syahrilTGR/IoT_BuahNagaFarm/images/esp32 38pin.webp

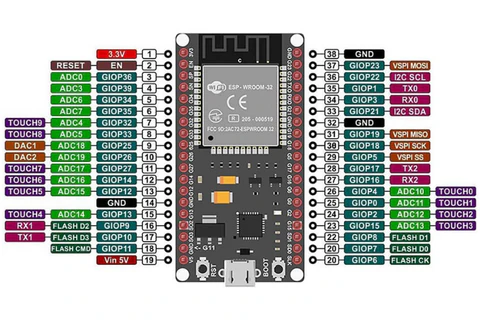
images/esp32 38pin.webp
