syahrilTGR/IoT_BuahNagaFarm/MEMORY.md

# Project Memory Index

- [Project Progress](memory/project-progress.md) — Current status: WiFi + Firebase + LED working, GPIO0 button not functional
