syahrilTGR/IoT_BuahNagaFarm/docs/note.md

Ukuran P x L (CM) :

plat panel :
43.7 x 37.2 

PSU :
11 x 7.8 
diameter lubang 3.5, jarak lubang (atas kiri) ke sisi samping 3 mm, dari atas ke sisi dalam 3.5 mm
lubang (bawah kanan): jarak dari samping 3.5 mm, dari bawah 2.5 mm
-miring:
Lubang bawah: dari bawah 3 mm, dari samping 7.1 mm
Lubang atas: dari atas 5.5 (sisi dalam), dari samping 7 mm

PCB:
15 x 10

PZEM :
7.5 x 3 , jarak tepi lubang 1 mm, diameter 3 mm

SSR :
3.5 x 2.5
jarak lubang ke tepi 1.5, diameter 3

SSR 2 chl:
55 x 33.1 mm,
jarak tepi ke lubang 1.5mm,
diameter lubang 3mm

zmpt
5.13 x 2.1
lubang ke tepi 1.5, diameter 2.5

lubang konektor fan: 7.2 x 6

PR:
switch kanan di align top dgn oled
screw terminal buat zmpt

relay 2 ch:
38.5 x 50
lubang ke atas 0.75 mm
lubang ke samping 0.75 mm
jarak sisi dalam lubang horizontal 30 mm
vert 42.5 mm
position:
163.83
7.366

jarak lubang ke sisi sisi : 0.8 rata - worstcase

----
note hardware:
- buzzer yang beep beep selama mati lampu, ganti dengan beep panjang 2 detik di awal mati lampu aja
