syahrilTGR/IoT_BuahNagaFarm/docs/2026-08-19-rtos-plan.md

# RTOS Implementation Plan — SmartNaga ESP32

**Tanggal:** 2026-08-19
**Status:** Planning
**Branch:** `feature/rtos-refactor`

---

## Goal

Refactor firmware ke FreeRTOS (3 task) agar buzzer & sensor tidak pernah blocking satu sama lain.

---

## Task Architecture

```
┌─────────────────────────────────────────────────────────────┐
│                      SMARTNAGA RTOS                         │
├──────────────────────┬──────────────────────┬────────────────┤
│   TASK BUZZER        │   TASK SENSOR        │  TASK NETWORK  │
│   (priority 3)       │   (priority 2)       │  (priority 1)  │
│   stack: 2048        │   stack: 4096        │  stack: 4096   │
├──────────────────────┼──────────────────────┼────────────────┤
│ - buzzer_on/off      │ - readPZEM()         │ - sendToFirebase()
│ - pln_alarm_repeat   │ - readZMPT()         │ - checkFirebaseCmds()
│ - toggle beep        │ - updateOLED()       │ - heartbeat
│ - silence_gap check  │ - queue data to NET  │ - queue data to SENSOR
├──────────────────────┼──────────────────────┼────────────────┤
│ PERIOD: 50ms         │ PERIOD: 100ms/1s/5s  │ PERIOD: 1s     │
│ QUEUE: buzzer_cmd    │ QUEUE: sensor_data   │ QUEUE: net_cmd │
└──────────────────────┴──────────────────────┴────────────────┘
```

---

## Queue Structure

```cpp
// Buzzer command queue (from Sensor/Network → Buzzer)
struct BuzzerCmd {
    enum Type { BEEP_200, BEEP_500 };
    Type type;
};
QueueHandle_t buzzerQueue;

// Sensor data queue (Sensor → Network)
struct SensorData {
    float blockA_V, blockA_I, blockA_P, blockA_E;
    float blockB_V, blockB_I, blockB_P, blockB_E;
    float zmpRms;
    bool plnAvailable;
    uint32_t timestamp;
};
QueueHandle_t sensorQueue;

// Network command queue (Network → Sensor/Buzzer)
struct NetCmd {
    enum Type { SET_LAMP_A, SET_LAMP_B, REQ_SYNC };
    Type type;
    bool state;
};
QueueHandle_t netCmdQueue;
```

---

## Implementation Steps

### Phase 1: FreeRTOS Setup (Day 1)
- [ ] Add `#include <freertos/FreeRTOS.h>` etc
- [ ] Create queues in `setup()`
- [ ] Create 3 tasks with proper priority/stack
- [ ] Test basic task scheduling (LED blink on each task)

### Phase 2: Buzzer Task (Day 1-2)
- [ ] Move buzzer logic ke `buzzerTask()`
- [ ] Receive from `buzzerQueue` (blocking receive)
- [ ] Implement internal timer (no external `millis()` dependency)
- [ ] Test: toggle A/B → beep 200ms, PLN off → beep 500ms/3s

### Phase 3: Sensor Task (Day 2-3)
- [ ] Move `readPZEM()`, `readZMPT()`, `updateOLED()` ke `sensorTask()`
- [ ] `readPZEM()` blocking OK di task ini (tidak ganggu buzzer)
- [ ] Push `SensorData` ke `sensorQueue` setiap 1s/5s
- [ ] Handle `netCmdQueue` untuk toggle lamp

### Phase 4: Network Task (Day 3)
- [ ] Move `sendToFirebase()`, `checkFirebaseCommands()` ke `networkTask()`
- [ ] Receive dari `sensorQueue` → push ke Firebase
- [ ] Poll `/lamp/control/{a,b}` → push ke `netCmdQueue`
- [ ] Heartbeat tiap 1s

### Phase 5: Integration & Testing (Day 4)
- [ ] End-to-end test: toggle A/B, PLN off/on, OLED, Firebase
- [ ] Verify no buzzer miss saat Firebase timeout 10s
- [ ] Stack watermark check (uxTaskGetStackHighWaterMark)
- [ ] Heap monitoring

---

## Priority & Timing

| Task | Priority | Period | Notes |
|---|---|---|---|
| Buzzer | 3 (high) | 50ms | Must never miss deadline |
| Sensor | 2 (med) | 100ms/1s | Blocking allowed |
| Network | 1 (low) | 1s | Can lag, non-critical |

**Priority inversion avoidance:** Gunakan `xQueueSend/Receive` dengan timeout, bukan mutex.

---

## Migration Checklist

| Legacy Code | RTOS Replacement |
|---|---|
| `loop()` | 3 tasks + queues |
| `Timer` struct + `millis()` | `vTaskDelayUntil()` / task period |
| `buzzerOn()` | `xQueueSend(buzzerQueue, ...)` |
| `readPZEM()` blocking | Sensor task internal |
| `sendToFirebase()` blocking | Network task internal |
| Global vars (`acVoltage`, `blockA`, etc) | Queue/notification passing |

---

## Memory Estimate

| Component | RAM |
|---|-----|
| 3 Task stacks | ~10KB |
| 3 Queues (small) | ~2KB |
| FreeRTOS kernel | ~4KB |
| **Total overhead** | **~16KB** (of 320KB) — acceptable |

---

## Rollback Plan

Jika RTOS gagal / crash:
- Branch terpisah `feature/rtos-refactor`
- Commit tiap phase untuk bisect
- Tag `pre-rtos` untuk rollback cepat

---

## Risks & Mitigation

| Risk | Mitigation |
|---|---|
| Stack overflow | `configCHECK_FOR_STACK_OVERFLOW=2`, `uxTaskGetStackHighWaterMark()` |
| Priority inversion | Queues + timeout, no mutex |
| Watchdog reset | Buzzer task feed watchdog; `CONFIG_ESP_TASK_WDT_TIMEOUT_S=30` |
| Queue full | `xQueueSend` timeout 0 (non-blocking), log drop |

---

## Success Criteria

- [ ] Buzzer beep 200ms/500ms **tidak pernah miss** walau Firebase timeout 30s
- [ ] PLN off → beep 500ms/3s **bersih tanpa overlap**
- [ ] OLED update 1s **tidak skip** walau PZEM 7s blocking
- [ ] Energy data ke Firebase **max 2s delay** dari sensor read
- [ ] Binary < 1.2MB flash, RAM < 200KB

---

## Next Action

Implement Phase 1-2 (Buzzer Task) — paling critical, paling cepat verify.
