syahrilTGR/IoT_BuahNagaFarm/memory/project-progress.md

---
name: project-progress
description: "Current progress of SmartNaga ESP32 firmware testing - WiFi, Firebase, LED working"
metadata: 
  node_type: memory
  type: project
  originSessionId: 16ef7975-35da-4052-ae32-14b6238d7351
  modified: 2026-07-28T07:57:29.177Z
---

## Progress Test Platform (test_platform.cpp)

### ✅ Working (2026-07-28)
- WiFi Manager: ESP32 bisa connect WiFi via AP portal
- Firebase RTDB: Upload status berhasil ke `/test/status`
- LED builtin (GPIO2): Belum diuji via Firebase command
- **GPIO4 sebagai test button input (dengan pullup internal)**

### ⚠️ Issues (Resolved)
- ~~GPIO0 (Boot button) tidak bisa dipakai untuk input — pin khusus download mode~~ → **Fixed: gunakan GPIO4**
- ESP32 pakai **38 pin** DevKit (bukan 30 pin)

### Hardware
- ESP32 DevKit 38-pin
- Pin: D13 → LLC → SSR (Blok A), D12 (Blok B), PZEM di RX2/TX2 (GPIO16/17)
- Builtin LED: GPIO2 (active LOW)

### Credentials
- Firebase project: control-and-monitoring-energy
- Firebase URL: https://control-and-monitoring-energy-default-rtdb.asia-southeast1.firebasedatabase.app/

### Environment
- `pio run -e test_platform` — build test firmware
- `pio run -t upload -e test_platform` — upload test firmware
- `pio monitor -e test_platform` — monitor serial

**Why:** Proyek sedang dalam tahap testing komponen dasar sebelum integrasi penuh.
**How to apply:** Lanjutkan testing dengan pin GPIO lain (bukan GPIO0/Boot button) untuk input/output test.
