syahrilTGR/IoT_BuahNagaFarm/hardware/Manual Book/LEMBAR_PANDUAN_RINGKAS_PANEL.md

# LEMBAR PANDUAN CEPAT (SOP PINTU PANEL)
## ALAT KONTROL LAMPU KEBUN BUAH NAGA — SMARTNAGA

> *Petunjuk ringkas untuk ditempel pada bagian dalam pintu box panel kebun.*

---

### 1. CARA MENYALAKAN ALAT (PAGI / PERTAMA KALI)
1. Colokkan kabel kontrol ke baterai cadangan (UPS).
2. Naikkan tuas **MCB Utama** ke atas (posisi **ON**).
3. Naikkan tuas **MCB Lampu** ke atas (posisi **ON**).
4. Tunggu bunyi *"Tit"* 1 kali dan layar kecil menampilkan jam kebun.

---

### 2. CARA SAMBUNG KE WIFI / MODEM BARU (3 MENIT)
Jika di layar muncul tulisan **`== SETUP WIFI ==`**:
1. Buka WiFi di HP ➔ Sambungkan ke **`SmartNaga-AP`** (Sandi: **`smartnaga123`**).
2. Buka Google Chrome di HP ➔ Buka alamat: **`192.168.4.1`**.
3. Klik **Configure WiFi** ➔ Pilih WiFi kebun Anda ➔ Masukkan sandinya.
4. Klik **Save**. Tunggu alat me-restart sendiri hingga layar tertulis **`Wifi: online`**.

---

### 3. ARTI TAMPILAN LAYAR KECIL
```
┌──────────────────────────────┐
│           19:15:00           │ ➔ Jam Kebun (Otomatis & Tepat)
│ Wifi: online 42ms            │ ➔ Internet Terhubung Lancar
│ Source: PLN                  │ ➔ Listrik Utama PLN Aktif
│ Blok A: 850W                 │ ➔ Pemakaian Listrik Blok A
│ Status: 10/10 Normal         │ ➔ Semua Lampu Blok A Sehat
│ Blok B: 850W                 │ ➔ Pemakaian Listrik Blok B
│ Status: 10/10 Normal         │ ➔ Semua Lampu Blok B Sehat
└──────────────────────────────┘
```

---

### 4. ARTI BUNYI ALARM
* **Bunyi "Tit" Pendek (1x):** Tanda saklar di HP berhasil ditekan (ON / OFF).
* **Bunyi "Tiiiiiit" Panjang (2 Detik):** **LISTRIK PLN PADAM!** Sistem beralih ke baterai cadangan dan mengirim peringatan ke HP pemilik kebun.

---

### 5. TINDAKAN CEPAT SAAT TERJADI KENDALA

| Tulisan di Layar | Apa Artinya? | Tindakan yang Harus Dilakukan |
|---|---|---|
| **`Status: 8/10 Normal`** | Ada 2 bohlam yang mati di kebun. | Sisir barisan pohon buah naga, cari 2 bohlam yang padam, lalu ganti dengan bohlam baru. |
| **`Status: Lampu Padam`** | Semua lampu mati padahal saklar ON. | Periksa tuas MCB Lampu di panel. Jika turun (trip), naikkan kembali. Jika langsung turun lagi, ada korsleting di kabel tiang. |
| **`Status: Listrik Padam`** | Aliran listrik PLN dari tiang jalan mati. | Tidak perlu diapa-apakan. Saat PLN kembali menyala, lampu akan otomatis hidup kembali. |
| **`Wifi: No Internet`** | Kuota modem habis / sinyal hilang. | Periksa paket kuota modem 4G kebun. Lampu tetap menyala sesuai jadwal otomatis. |
| **`Status: Relay Bocor`** | Lampu tetap nyala padahal saklar OFF. | Turunkan tuas MCB Lampu sementara waktu agar hemat listrik, lalu hubungi teknisi. |

---

### ⚠️ PERINGATAN KESELAMATAN (K3)
1. **Dilarang menyentuh kabel telanjang** saat listrik sedang menyala.
2. Selalu gunakan **alas kaki karet kering** saat membuka panel.
3. Selalu **kunci pintu box panel rapat-rapat** setelah selesai agar tidak kemasukan air hujan dan serangga.
