syahrilTGR/IoT_BuahNagaFarm/todo.md

pelajari:
- millis()
- rangkaian pzem ke esp32

note:
- yg ke SSR itu yg line phase
- esp32 ada berapa uart
- nyalanya lampu tu ngga semalaman
- ssr udah bisa, dari esp langsung ssr, sebelumnya pake LLC, gabisa, kyk nya LLC nya rusak, di sisi 5v ngga mau ke state low

di esp
- daya di oled buat atas bawah aja

di App
- [x] tambah estimasi rup
- [x] coba ekspor historis dari firestore ke spreadsheet/csv
- [x] di setting, tambahkan inputan daya dan jumlah lampu default, yang nantinya disimpan ke firebase dan digunakan sebagai acuan kondisi normal atau tidak
- [x] notif lampu padam (dari ZMPT), nanti source nya berubah jadi UPS

di App — PERLU DIPERBAIKI (temuan audit firmware 2026-09-25)
- [x] **`_zmptVoltage` sebenarnya berisi tegangan PZEM Blok A, bukan ZMPT.**
      Di `home_screen.dart` ada DUA listener menulis ke `_zmptVoltage`:
        1. `_plnRef.child('voltage')` (L162) → `/energy/pln_status/voltage` **TIDAK ADA** → listener mati, tidak pernah fire
        2. `_energyRefA.child('voltage')` (L172) → `/energy/block_a/voltage` → ini yang jalan (PZEM, ~238V)
      Jadi tampilan tegangan "kebetulan" benar angkanya, tapi sumbernya PZEM Blok A — bukan ZMPT.
      → Hapus listener mati (L162-170), dan putuskan mau pakai yang mana:
        - **PZEM Blok A** (tegangan di sisi beban) — kalau mau tetap seperti sekarang, rename variabelnya
        - **ZMPT** (`/energy/z_mpt/voltage_real`, tegangan di jalur PLN sebelum stopkontak) — kalau mau bedakan
- [x] **Field baru `voltage_real`** — firmware kirim volt terkalibrasi (RMS × 0.667) ke
      `/energy/z_mpt/voltage_real`. Ini satu-satunya sumber tegangan dari ZMPT.
- [x] **`voltage_raw` = RMS ADC mentah, BUKAN volt** — nilainya ~0-500 (contoh 356), bukan ~238.
      Jangan ditampilkan sebagai volt.
- [x] **Heartbeat staleness tidak konsisten** — `control_screen.dart` pakai 10s, `home_screen.dart`
      pakai 15s. Firmware kirim tiap 2.5s. Samakan (usul 10s = 4 beat terlewat).
- [x] **Status PLN bisa flicker saat transisi** — firmware kirim `/energy/pln_status/available`
      dari nilai INSTAN, bukan yang sudah di-debounce. Saat PLN baru mati/nyala, app bisa
      sempat menampilkan status salah ~300ms. Pertimbangkan smoothing di app (debounce 2-3s)
      atau perbaiki di firmware (pakai `plnPrevState`).
- [x] **BUG: arus & daya stuck di nilai terakhir saat PLN mati** (dilaporkan 2026-09-25)
      Gejala: PLN normal + lampu nyala → terukur arus & daya. Lalu PLN mati →
      nilai arus/daya **tidak reset ke 0**, tetap menampilkan angka terakhir.

      **Akar masalah ADA DI FIRMWARE, bukan app.** Alur:
        1. `src/main.cpp:341` — `readPZEM()` di-SKIP total saat PLN mati:
           `if (now - timerPZEM.prev >= timerPZEM.interval && plnPrevState)`
        2. `blockA` / `blockB` jadi variabel basi (nilai terakhir sebelum PLN mati)
        3. `sendToFirebase()` tetap kirim `blockA.power` / `blockA.current` yang basi
           itu ke `/energy/block_{a,b}` setiap 2.5s
        4. App menerima nilai valid → tidak ada cara tahu itu sudah tidak berlaku

      **Fix firmware — yang harus dilakukan:**
        Kirim `valid` di JSON `/energy/block_{a,b}`:

        ```cpp
        // Gabung dua kondisi — JANGAN kirim blockA.valid apa adanya!
        // Saat PLN mati, readPZEM() di-skip sehingga blockA.valid tetap
        // bernilai true dari pembacaan terakhir (basi).
        bool validA = plnPrevState && blockA.valid;
        bool validB = plnPrevState && blockB.valid;
        ```

        ⚠️ Jebakan: `blockA.valid` dihitung DI DALAM `readPZEM()` (L431).
        Karena `readPZEM()` di-skip saat PLN mati, nilai itu tidak pernah
        diperbarui → tetap `true`. Kalau dikirim apa adanya, bug tidak
        terselesaikan.

      **Catatan penting (dikoreksi 2026-09-25):** Lampu terhubung **langsung ke PLN
      tanpa UPS** — UPS hanya menopang ESP32 + sensor + modem 4G. Jadi saat PLN mati,
      lampu memang mati dan arus yang benar adalah **0**. Reset ke 0 adalah perilaku
      yang TEPAT, bukan sekadar workaround.

      Jadi Opsi A sudah benar. VCC PZEM 5V (item hardware) tetap layak dikerjakan
      untuk stabilitas komunikasi saat PLN normal, tapi tidak mengubah keputusan
      `valid` di atas.

      **Sisi app (SUDAH DIKERJAKAN):**
        - `home_screen.dart:132` pakai assignment langsung → ikut nilai dari Firebase,
          jadi otomatis benar begitu firmware kirim 0.
        - `anomaly_listener_service.dart` sudah baca flag `valid`:
          `final bool isValid = val['valid'] != false; if (!isValid) { _powerA = 0.0; ... }`

      ✅ **SELESAI — firmware sudah kirim flag `valid`** (commit 42328cd)
        ```cpp
        bool validA = plnPrevState && blockA.valid;
        bool validB = plnPrevState && blockB.valid;
        energyJson.set("valid", validA);
        ```
        Build sukses (RAM 16.0%, Flash 96.8%). Perlu diuji lapangan:
        PLN mati → arus/daya harus reset ke 0 di app.

di RTDB
- add tugangan zmpt ke firebase
- [/device/ping] tambah node ping: online (bool), latency_ms (int), timestamp (int), **ssid (string)** — [x] firmware sudah kirim

di hardware
- buzzer PLN mati: ganti beep-beep (500ms/3s) jadi beep panjang 2 detik di awal mati lampu aja [x]
- PZEM VCC: 3.3V → 5V (spec PZEM-004T v3.0 = 5V, komunikasi gagal saat PLN mati)
- PZEM AC input: pastikan dari UPS (bukan PLN) kalau mau tetap monitor saat outage
- ZMPT potentiometer: kalibrasi ulang (putar sampai baseline ~2200 dan RMS 230+) [x] — hasil: PLN ON RMS 355.5 Vpp 937, PLN OFF RMS 6.5 (margin 53x)
- voltage_raw di Firebase: nilai RMS ADC mentah, belum dikonversi ke volt
- tulisan src di oled, geser ke kanan, jdi tulisan ups atau PLN itu mentok ke kanan [x]
- trus tulisan wifi: ON / OFF, ganti dengan tulisan ONLINE, OFFLINE. cek apakah cukup ruang di olednya? [x]
- ESP32 reboot (POWERON_RESET) saat PLN dicabut — cek apakah disupply dari UPS atau USB saat test

di OLED (permintaan Pak Amin Rodhi, 2026-09-28)
- [x] Ping 8.8.8.8 tiap 3 detik → tampil "Wifi: online XXms" / "Wifi: offline"
- [x] Layout 7 baris: Waktu / Wifi+ping / Source / Blok A: daya / Status / Blok B: daya / Status
- [x] "Status" di Blok A/B = nilai daya (W) + status perintah SSR (ON/OFF)
- [x] Status label: `Rusak (N)` dengan `brokenLamps` (clamp 1..lampCount)
- [x] Font: size 1 untuk semua baris, waktu size 2 (paling besar di baris 1)
- [DICOBA, DIBATALKAN] Font FreeSans9pt7b (14px) sempat dicoba, tapi hasilnya
      kurang bagus — user revert ke size 1/2 built-in. Alasan teknis: font
      proportional hanya muat 4 baris, dan setCursor jadi baseline (bukan top-left)
      sehingga tata letak harus dirombak.

---

## Firmware
- [x] PZEM B baca data
- [x] SSR B pin dipindah ke GPIO27 (sekarang relay biasa 2-channel active LOW)
- [x] Timestamp pakai NTP epoch seconds
- [x] Firmware hanya tulis `/energy/block_{a,b}`, app handle `/lamp/status/{a,b}`
- [x] Debounce Firebase command (2s) cegah flicker saat SSL reconnect
- [x] Boot: semua lamp OFF, baca status dari RTDB setelah connect
- [x] Lamp B bisa dikontrol dari app (sudah di code, perlu test)
- [x] Decision tree 10-status di firmware (port presisi dari app)
- [x] Threshold identik app: leak 2.0W/0.05A, PLN 50V, under 190V, over 245V, broken 2.0W/0.3x, ppl 9.0W, tol 15%
- [x] Freshness gate: lastGoodMs + usable gate (10s)
- [x] sensorOk synthesis: inGrace || !plnPrevState || (valid && fresh)
- [x] Config dari Firebase: expected_power, lamp_count, tolerance_percent
- [x] Config polling: 5 menit → 10 detik (timerConfig)
- [x] Settling 4 detik post-toggle
- [x] OLED 7-label: `Rusak (N)` dengan brokenLamps clamp 1..lampCount
- [x] Relay boot glitch fix: digitalWrite(HIGH) SEBELUM pinMode(OUTPUT)
- [x] SSID ke Firebase: /device/ping.ssid

---

## App (SmartNaga)
- [x] Align timestamp: firmware pakai epoch seconds → app parse `DateTime.fromMillisecondsSinceEpoch(timestamp * 1000)`
- [x] `getEnergyStream()` hanya baca `/energy/block_a` → tambah stream `/energy/block_b` (sudah listen langsung Blok A & B)
- [x] `home_bloc.dart`: tambah `energyB` + `lampBOn` ke state (arsitektur beralih ke stream langsung & session service)
- [x] `home_screen.dart`: tambah metrics grid Blok B + lamp toggle Blok B (total power & control screen per blok)
- [x] `control_screen.dart`: sudah OK (both blocks)
- [x] `historical_screen.dart`: tambah filter chip (1 Jam, 6 Jam, 1 Hari, 7 Hari, 30 Hari)
- [x] `settings_screen.dart`: align dengan design
