syahrilTGR/IoT_BuahNagaFarm/(list of files, drawings)

Other design files:
hardware/skema rangkaian.fzz
