syahrilTGR/IoT_BuahNagaFarm/(commit log)

2026-07-30 feat: production firmware scaffolding (ESP32 + PZEM + WiFiManager)
2026-07-30 feat: test firmware (WiFiManager + Firebase RTDB + button + LED)
2026-07-30 docs: hardware components & circuit diagrams
    [skema rangkaian.fzz]
2026-07-30 docs: add mobile app PRD, wiring, firebase rules, troubleshooting
2026-08-03 fix: exclude test_platform.cpp from esp32dev build, remove duplicate Serial2.begin(); update wiring diagram and add ESP32 pinout image
    [skema rangkaian.fzz]
2026-08-05 fix: add button debounce (200ms), update PZEM wiring to GPIO32/33, add PZEM-004T documentation
2026-08-05 docs: update todo notes and wiring diagram
2026-08-05 feat: integrate Firebase RTDB for energy data and lamp control
    - Add Firebase ESP Client library support
    - Implement setupFirebase() with credential handling
    - sendToFirebase(): push voltage, current, power, energy to /energy/block_a
    - sendToFirebase(): push lamp state to /lamp/status/a
    - checkFirebaseCommands(): listen to /lamp/control/a for remote toggles
    - Add 18% more flash usage (93.8%) for Firebase library support
2026-08-11 feat: add Blok B support, fix SSR B pin, NTP timestamp, debounce
2026-08-12 fix: OLED boot screen tampil sebelum WiFi connect + power A/B vertikal
    - OLED init awal setup(), tampil 'SmartNaga v2 Booting...'
    - WiFi autoConnect blocking tapi OLED sudah menyala
    - updateOLED() jalan di loop() tiap 1 detik
    - Power A & B vertikal atas-bawah di OLED (text size 2)
2026-08-12 feat: ZMPT print ke Serial Monitor tiap 5 detik (throttled)
2026-08-12 feat: PZEM B + SSR B, ZMPT raw, non-blocking WiFi/Firebase, buzzer alarm, remove button
    - Add PZEM B (Serial1 GPIO25/26) and SSR B (GPIO12)
    - ZMPT101B: raw RMS, threshold 200, PLN/UPS detection
    - WiFi + Firebase init: non-blocking state machine in loop()
    - OLED: boot screen before WiFi, power A/B vertical
    - Buzzer: 100ms toggle beep, 2s periodic alarm on PLN loss
    - Remove physical button (GPIO4), control via Firebase only
    - Separate debounce timers for A and B
    - Send /energy/pln_status for notification trigger
2026-08-18 feat: add DS3231 RTC + buzzer queue fix + pin swap SSR_B to GPIO4
    - Integrasi DS3231 RTC (I2C share OLED), sync NTP once, OLED pakai RTC
    - Buzzer queue: anti-overlap saat toggle A+B bersamaan
    - SSR_B pindah dari GPIO27 ke GPIO4 untuk avoid buzzer noise
    - Tambah 30ms SSR settle delay sebelum buzzer di setLampA/setLampB
    - Fix comment PZEMB pins (GPIO25/26 = Serial1, bukan I2C)
    - Add adafruit/RTClib@^2.1.4 ke platformio.ini
2026-08-19 feat: add device heartbeat + ZMPT raw voltage + 1s sensor interval
    - PZEM + Firebase interval 5s/10s → 1s untuk real-time
    - Add voltage_raw (RMS ADC) to /energy/z_mpt untuk raw data
    - Add /device/heartbeat tiap 1 detik untuk app-side online detection
2026-08-19 fix: buzzer alarm nyala terus saat PLN mati
    Root cause: sendToFirebase() & readPZEM() blocking (1-7s) mengganggu
    buzzer timer expiry. Semasa alarm aktif, blocking calls membuat
    buzzer mati terlambat atau timer terus reset.
    Fix:
    - Buzzer OFF check pindah ke step 0 (paling pertama), sebelum PZEM/Firebase
    - Alarm repeat pindah ke loop() step 0, trigger hanya jika !buzzerActive
    - readPZEM() skip saat PLN mati (PZEM AC-powered, tidak perlu)
    - Hapus queue logic (buzzerOn override langsung)
    - Hapus delay(30) di setLampA/B (blocking)
    - PZEM interval 5s (bukan 1s) untuk jaga blocking time
    - Alarm beep 500ms setiap 2s (distinct dari toggle 200ms)
2026-08-19 fix: buzzer silence gap + safety net OFF check in readZMPT
    - Alarm repeat: require 1s minimum silence after buzzer OFF
    - Alarm interval: 2s → 3s (akomodasi blocking)
    - buzzerOffTime tracking untuk silence gap enforcement
    - Safety net buzzer-OFF check di awal readZMPT()
    - PZEM interval 5s → 1s (skip saat PLN mati, blocking hanya saat ON)
2026-08-19 docs: buzzer alarm fix — root cause analysis & solution
2026-08-19 docs: RTOS plan (considered, not implemented — current fix sufficient)
2026-08-26 fix: buzzer timing pakai millis() + PZEM/Firebase interval 2.5s
    - buzzer OFF check gunakan millis() langsung (bukan now yang bisa stale)
    - buzzerOffTime gunakan millis()
    - alarm repeat gunakan millis() untuk akurasi timing
    - PZEM interval 1s → 2.5s (balance antara responsif dan blocking)
    - Firebase interval 1s → 2.5s (kurangi network load)
2026-08-26 docs: arsitektur sistem — wiring detail, data flow, timing table
2026-09-24 fix: PLN alarm beep panjang 2 detik sekali (bukan repeat 500ms/3s)
    - Hapus alarm repeat loop (step 0b)
    - Hapus variabel plnAlarmActive & lastPlnAlarm
    - Ganti buzzerOn(500) → buzzerOn(2000) di transisi PLN→UPS
    - Buzzer OFF check tetap di step 0 (paling atas)
2026-09-25 feat: WiFi reset command + ZMPT sampling overhaul
    WiFi reset (dari app via /system/reset_wifi):
    - Poll tiap 3s, set flag false, wm.resetSettings(), ESP.restart()
    - Hapus delay(500) blocking sebelum restart (risiko WDT)
    - Config Portal AP: SmartNaga-AP / smartnaga123
    - OLED tampilkan instruksi setup WiFi saat portal aktif
    ZMPT sampling (fix bug baseline dua-jendela):
    - 600 sampel ke buffer, baseline + RMS dari jendela yang SAMA
    (sebelumnya baseline dari 200 sampel pertama, RMS dari 200 berikutnya
    yang berjalan ~30ms kemudian -> RMS ngawur saat transisi PLN)
    - Jitter turun dari +/-7% ke +/-0.5% (355.1-358.3)
    - Kalibrasi volt: ZMPT_K = 0.667 (dari 10 pasang data vs PZEM)
    - Debounce state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
2026-09-25 feat: ZMPT101B diagnostic tool + test_zmpt env
    - src/test_zmpt.cpp: sampling 1 detik (50 siklus), hitung Min/Max/Mid/Vpp/
    Base/RMS, kasih rekomendasi putar baut CW/CCW
    - platformio.ini: env test_zmpt + cheatsheet CLI per-OS
    - Filter -<test_zmpt.cpp> di env esp32dev & test_platform
    Hasil kalibrasi (tercatat di header file):
    PLN ON : RMS 355.5 Vpp 937 Base 1795
    PLN OFF : RMS 6.5 Vpp 48 Base 1805
    Margin 53x, threshold 150 aman
2026-09-25 docs: diagram arsitektur drawio + catatan ukuran panel
    - arsitektur-sistem.drawio: 4 layer (AC power, DC power, controller, cloud)
    dengan warna per jenis jalur (AC merah, DC oranye, I2C hijau, GPIO pink)
    - note.md: ukuran fisik plat panel, PSU, dll untuk perakitan
2026-09-25 docs: TODO temuan audit app + status kalibrasi ZMPT
    Temuan audit smartnaga_app (5 item):
    - _zmptVoltage berisi tegangan PZEM Blok A, bukan ZMPT (2 listener,
    1 mati karena /energy/pln_status/voltage tidak ada)
    - Field voltage_real baru belum dipakai app
    - voltage_raw = RMS ADC (~356), bukan volt — jangan ditampilkan sebagai volt
    - Heartbeat staleness tidak konsisten (10s vs 15s)
    - Status PLN flicker saat transisi
    Update hardware:
    - ZMPT kalibrasi selesai (RMS 355.5 PLN ON, 6.5 PLN OFF)
    - Tambah item: ESP32 POWERON_RESET saat PLN dicabut
2026-09-25 docs: konsolidasi file instruksi ke AGENTS.md
    - CLAUDE.md -> AGENTS.md (agar dibaca Claude Code & Antigravity)
    - CLAUDE.md sekarang berisi '@AGENTS.md' (import, bukan symlink —
    repo dipakai lintas macOS & Windows, symlink rusak di Windows)
    - Gabung .claude/CLAUDE.md lalu hapus (file instruksi kedua yang
    tetap ikut dimuat dan bertentangan)
    Koreksi fakta yang salah:
    - 'firmware/' -> PlatformIO root ada di root repo, source di src/
    - command 'cd firmware && pio run' -> 'pio run' dari root
    - Hapus klaim fork claudecode/gitbr/change (remote: syahrilTGR/IoT_BuahNagaFarm)
    Info yang dipertahankan dari .claude/CLAUDE.md:
    - Library preferences (pio lib install)
    - Test & documentation requireme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
2026-09-25 docs: tandai 5 item app selesai + catat firmware belum kirim flag valid
    Terverifikasi di smartnaga_app:
    - Listener mati /energy/pln_status/voltage sudah dihapus
    - voltage_real sudah dipakai (home_screen.dart:182)
    - voltage_raw sudah tidak dipakai
    - Heartbeat staleness disatukan ke AppConstants.heartbeatStaleMs = 10000
    - PLN debounce smoothing sudah ada (commit ea489a1)
    - anomaly_listener_service sudah baca flag valid -> reset 0
    Temuan baru: firmware BELUM kirim field 'valid', dan skip PZEM (L341)
    masih ada. App sudah siap, firmware belum. Bug 'arus & daya stuck'
    masih terjadi sampai firmware diperbaiki.
2026-09-25 docs: koreksi arsitektur — lampu TANPA backup UPS
    Koreksi fakta penting: lampu terhubung LANGSUNG ke PLN via SSR.
    UPS hanya menopang ESP32 + sensor + modem 4G.
    Yang diperbaiki:
    - Diagram utama: pisahkan jalur lampu (PLN) vs jalur kontrol (UPS)
    - Section 2.1 Power Supply Chain: hapus klaim UPS di jalur lampu
    - Section 6 AC Distribution: tulis ulang, buang 'UPS AC Live masuk
    stopkontak yang sama'
    - Section 'PLN -> UPS Failover' -> 'PLN Mati - Perilaku Sistem'
    - Power budget: lampu sumbernya PLN saja, bukan PLN/UPS
    - Failure modes: ganti 'UPS battery low' (tidak ada deteksi) dengan
    perilaku PLN mati yang sebenarnya
    Konsekuensi di TODO: kesimpulan 'arus sebenarnya bukan nol saat PLN mati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
2026-09-25 docs(hardware): add 12-pin terminal block wiring photo
2026-09-25 fix: kirim flag valid di /energy/block_{a,b} untuk atasi arus/daya stuck
    Bug: saat PLN mati, arus & daya tetap menampilkan nilai terakhir
    (tidak reset ke 0) di app.
    Akar masalah: readPZEM() di-SKIP saat PLN mati (L341), sehingga blockA/
    blockB jadi variabel basi. sendToFirebase() tetap mengirim nilai basi itu
    ke Firebase, dan app tidak punya cara tahu data sudah tidak berlaku.
    bool validA = plnPrevState && blockA.valid;
    bool validB = plnPrevState && blockB.valid;
    energyJson.set("valid", validA);
    Jebakan yang dihindari: TIDAK mengirim blockA.valid apa adanya.
    Field itu dihitung DI DALAM readPZEM() (L431) yang di-skip saat PLN mati,
    jadi nilainya tetap true dari pembacaan terakhi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
2026-09-28 feat: ping 8.8.8.8 + OLED status line + WiFi latency
    - Ping google.com (8.8.8.8) tiap 3 detik via ESP-IDF esp_ping (non-blocking)
    - Variables: lastPingOk, lastPingMs, pingHandle (session guard)
    - Callback handlers update state; results sent to /device/ping
    - OLED layout 7 baris size 1 (per Pak Amin Rodhi):
    y=0 : Waktu (rata tengah)
    y=8 : Wifi: online XXms / offline
    y=16 : Source: PLN / UPS
    y=24 : Blok A: XXXXW
    y=32 : Status: Standby / Normal / Gangguan
    y=40 : Blok B: XXXXW
    y=48 : Status: Standby / Normal / Gangguan
    - Status evaluasi lokal (ringkas, 3 label):
    - Standby : relay OFF, tidak ada beban
    - Normal : relay ON, ada beban, PLN OK
    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
2026-09-28 feat: decision tree 10-status + OLED label count + config refresh 10s + relay boot glitch fix
    - Decision tree 10-status port presisi dari app
    - Threshold identik app: leak 2.0W/0.05A, PLN 50V, under 190V, over 245V, broken 2.0W/0.3x, ppl 9.0W, tol 15%
    - Freshness gate: lastGoodMs di readPZEM(), usable = plnPrevState && valid && fresh (10s)
    - sensorOk synthesis: inGrace || !plnPrevState || (valid && fresh) — mencegah PLN outage jadi sensorError
    - Config dari Firebase: readConfigOnce() via FirebaseJson, one-shot boot + 10s periodik (was 5 min)
    - Settling 4s post-toggle: lampToggleMsA/B di setLampA/B()
    - OLED 7-label: dengan brokenLamps = clamp(1..lampCount)
    - Relay boot glitch fix: digitalW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
2026-09-28 docs: sync arsitektur + todo dengan implementasi decision tree
    docs/2026-08-19-arsitektur-sistem.md:
    - Buzzer pin GPIO23 -> GPIO27 (2 tempat: diagram + tabel aktuator)
    - SSR -> Relay (relay 2-channel biasa, active LOW, NO)
    - ZMPT 400 -> 600 sampel
    - Tambah /device/ping.ssid
    - Tambah /config/block_{a,b} (expected_power, lamp_count, tolerance_percent)
    - Tambah section 4.1 Decision Tree di Firmware (10 status + threshold)
    - Timing: tambah config read 10 detik
    - Failure Modes: PZEM basi, config absen, relay boot glitch
    - Dependencies: catat ArduinoJson 0 symbols, esp_ping built-in
    - Future: push notif 24/7, publish diag ke RTDB
    TODO.md:
    - Tandai selesai: ping, OLED 7-baris, decision tree, confi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
2026-09-29 feat: OLED status 'menyala/total Normal' — "Status: 1/2 Normal"
    - Update formatStatusLine() untuk tampil 'Status: N/T Normal'
    - Contoh: lamp_count=2, broken=1 -> 'Status: 1/2 Normal'
    - Lebar 18 char (108px) aman di 128px
    - Keterangan 'Normal' konsisten dengan kosakata app (Lampu Normal)
2026-09-29 feat(firebase): deploy RTDB rules, /device/ping, /lamp/diag, /system paths
2026-09-30 feat(firmware): sync state lampu dari Firebase saat boot
    Hapus setBool(false) ke /lamp/control/{a,b} yang dijalankan SEBELUM
    pembacaan — tulis-destruktif ini menimpa state terakhir yang di-set user
    dari app, sehingga lampu selalu ikut mati saat ESP32 boot.
    /lamp/control/{a,b} adalah milik app. Firmware sekarang hanya BACA;
    default OFF dipakai sebagai fallback aman kalau pembacaan gagal.
    Tambah [BOOT] serial log untuk verifikasi state yang di-sync.
2026-09-30 fix(history): deklarasikan composite index Firestore untuk query histori - Tambah firebase/firestore.indexes.json (energy_sessions: userId ASC, startAt DESC) - Tambah section firestore di firebase.js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
2026-09-30 fix(firmware): instrumentasi diagnosis stall loop dan kurangi beban polling - Tambah fbTimed() untuk log setiap call Firebase > 500ms - Tambah printResetReason() untuk bedakan crash vs loop stall - s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
2026-10-06 fix(firmware): perbaiki jam OLED tampil "45" — validasi & init RTC
    Akar: blok RTC di setup() kebalik — rtc.adjust() dipanggil saat RTC
    TIDAK ditemukan (gagal diam-diam), dan saat RTC ada tidak pernah di-set.
    Jika NTP sync gagal (coba 1x, tunggu 2s), register DS3231 yang rusak
    tampil apa adanya: bcd2bin(0x45) = 45 → OLED menampilkan "jam 45".
    - Tambah rtcTimeValid(): validasi year 2020-2099, month/day/jam/min/det
    - setup(): set waktu compile hanya saat RTC tidak ada / tidak valid;
    kalau RTC valid, jangan ditimpa
    - syncRTC(): coba NTP 3x (bukan 1x), log tiap percobaan
    - updateOLED(): guard tampilkan "--:--:--" bila waktu tidak valid
    Build sukses: Flash 40.7%, RAM 16.1%.
    Co-Authored-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
2026-10-22 docs: update README with current hardware stack, structure, and quick start
2026-10-30 refactor(firmware): swap Blok A/B pins and update naming for contactor relay
2026-10-30 feat(ota): enable ArduinoOTA support with min_spiffs partition scheme
2026-11-02 feat(firmware): handle wifi without internet gracefully and prevent loop stalls
